ErickSlivinski/ProjetoTCC/EsquemaConexões.png

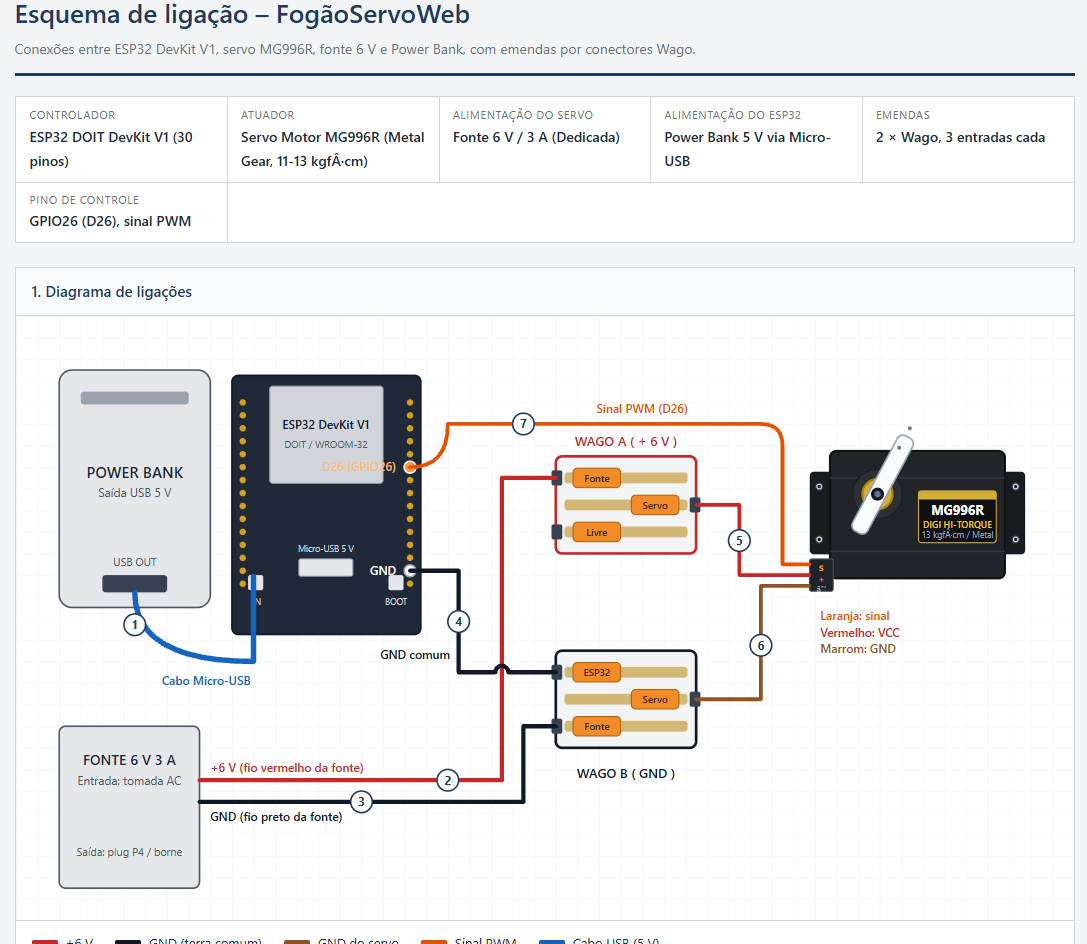
EsquemaConexões.png
