ErickSlivinski/ProjetoTCC/Eng22DenteServo.stl

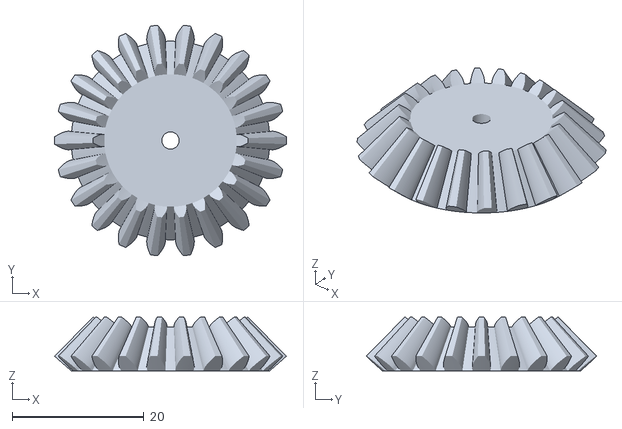
[picture p2: CAD file, 2026-11-10]
Eng22DenteServo.stl
35.3 x 35.0 x 8.15
