ErickSlivinski/ProjetoTCC/MontagemGeralFinal.stl

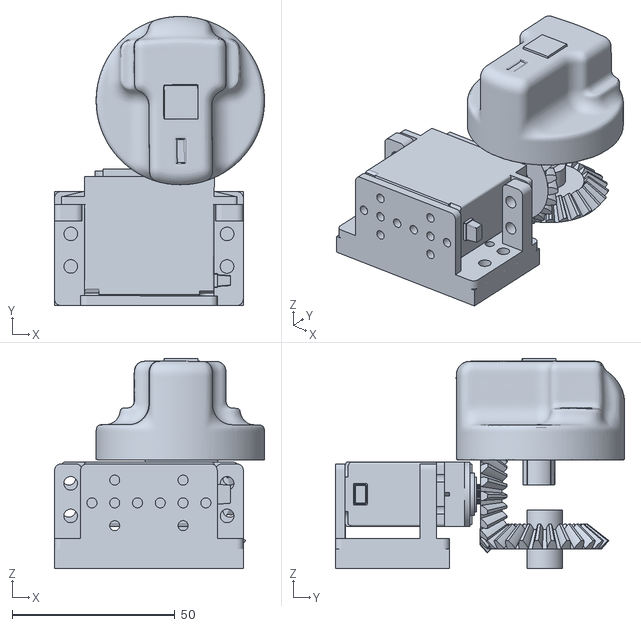
[picture p3: CAD file, 2026-11-10]
MontagemGeralFinal.stl
64.5 x 88.8 x 64.5
