ErickSlivinski/ProjetoTCC/Eng25DentesBase.stl

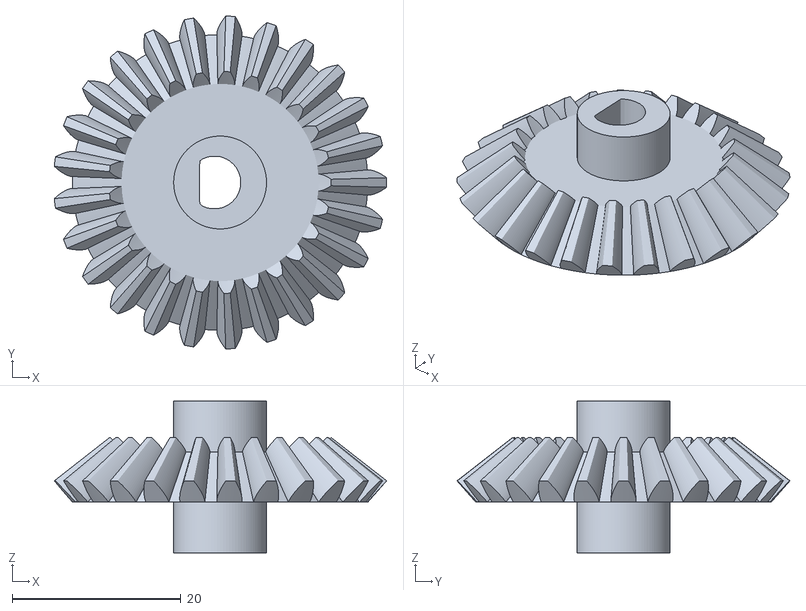
[picture p4: CAD file, 2026-11-10]
Eng25DentesBase.stl
39.4 x 39.5 x 18.0
