ErickSlivinski/ProjetoTCC/BaseComManipulo.stl

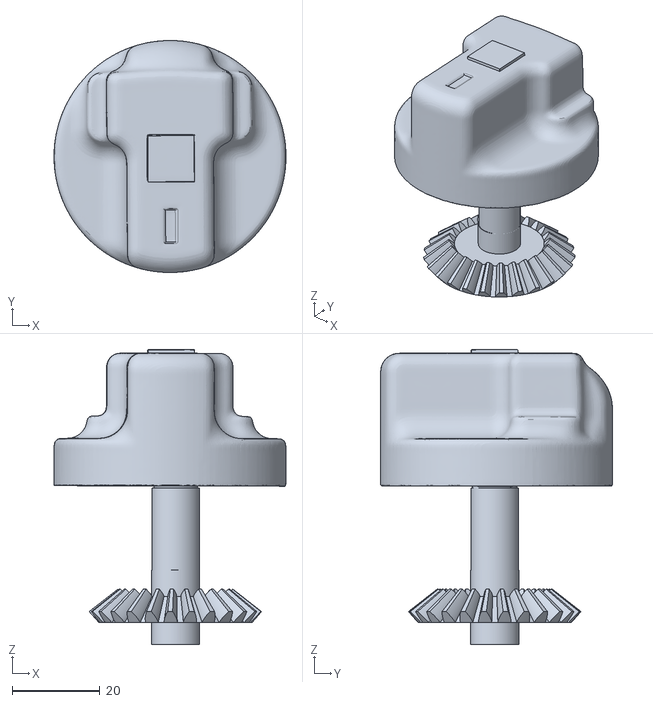
[picture p5: CAD file, 2026-11-10]
BaseComManipulo.stl
53.0 x 53.0 x 67.4
