ErickSlivinski/ProjetoTCC/Base996r.stl

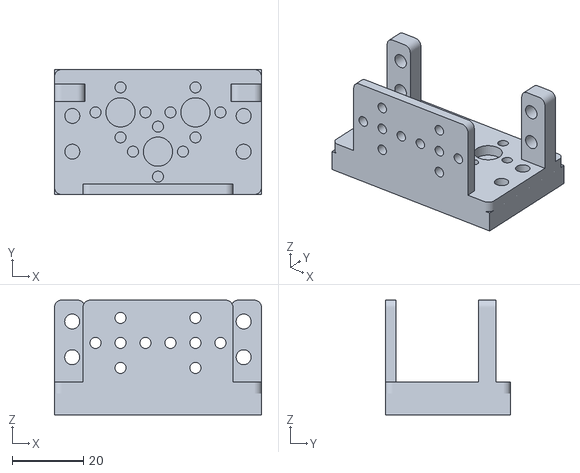
[picture p6: CAD file, 2026-11-10]
Base996r.stl
58.0 x 35.0 x 32.2
