ErickSlivinski/ProjetoTCC/(commit log)

2026-10-18 Commit inicial: firmware ESP32, modelos 3D STL, simuladores web e documentacao
    [BaseFlange_Furo10.09mm.stl, EngrenagemBase_Compacta_Furo8mm.stl, EngrenagemBase_Flange28mm_Furo8mm.stl, EngrenagemBase_Furo9.5mm.stl, EngrenagemMenor_EstiloBase_Furo4.9mm.stl, EngrenagemMenor_Furo4.9mm.stl, EngrenagemPequena_22d_Parede3mm.stl, EngrenagemPequena_24d_Furo4.7mm.stl]
2026-10-18 Limpeza do repositorio: mantendo apenas as pecas 3D finais (BaseFlange 10.09mm e EngPeq 4.70mm), firmware, diagramas e simuladores
    [EngPeq4.70mm.stl, EngrenagemBase_Compacta_Furo8mm.stl, EngrenagemBase_Flange28mm_Furo8mm.stl, EngrenagemBase_Furo9.5mm.stl, EngrenagemMenor_EstiloBase_Furo4.9mm.stl, EngrenagemMenor_Furo4.9mm.stl, EngrenagemPequena_22d_Parede3mm.stl, EngrenagemPequena_24d_Furo4.7mm.stl]
2026-11-10 feat: atualiza arquitetura para servo MG996R, transmissao 22:25, novos STLs e dossie tecnico v2
    [Base996r.stl, BaseComManipulo.stl, Caixa_ESP32_base.stl, Caixa_ESP32_tampa.stl, Eng22DenteServo.stl, Eng25DentesBase.stl, MontagemGeralFinal.stl]
2026-11-10 docs: expande README.md unindo explicacao detalhada de uso, rotas, calibracao e versao 2.0 com MG996R
2026-11-10 style: atualiza esquema eletrico visual HTML com a silhueta robusta e especificacoes do servo MG996R
2026-11-10 Update servo specifications in HTML document
2026-11-10 Rename Captura de tela 2026-11-10 001024.png to EsquemaConexões.png
2026-11-10 fix(firmware): calibra pulsos do MG996R (450-2550us) e adiciona retencao de torque (hold 450ms) para fechamento estanque 100%
    [CódigoWeb.ino]
